Grsliy/Tapping-system-for-laboratory/Referensi/Modul_IoT_sementara.pdf

Modul Internet of Things: Menggunakan STM32 + ESP01 Praktikum Senior Project, Lab Dasar 2 Departemen Teknik Elektro dan Teknologi Informasi, Fakultas Teknik, Universitas Gadjah Mada

Pengaturan IOC pada STM32CubeIDE

### 1. Buat New Project sesuai dengan tipe STM32 kalian, contoh: STM32F401CDU6, sampai

selesai dan tertampil file IOC kalian.

### 2. Klik “System Core” > RCC > High Speed Clock (HSE) set sebagai “Crystal/Ceramic

Resonator”

### 3. Klik “System Core” > SYS > Debug set sebagai “Serial Wire” 4. Klik “Connectivity” > USART1 > Mode set sebagai “Asynchronous” dan pastikan pada

Parameter Settings > Basic Parameters > Baud Rate > 115200 Bits/s

### 5. Kilk save sampai ter-generate main.c, kemudian edit main.c berikut:

Percobaan 1: STM32+ESP01 berlaku sebagai server yang membuat its own wifi connection, dan HP/laptop terkoneksi ke wifi stm32 dengan memasukkan SSID dan Password, kemudian membuka website 192.168.51.1 dan mengendalikan LED STM32 menggunakan tombol di website tersebut.

Di user code begin 2:

Departemen Teknik Elektro dan Teknologi Informasi, Fakultas Teknik, Universitas Gadjah Mada

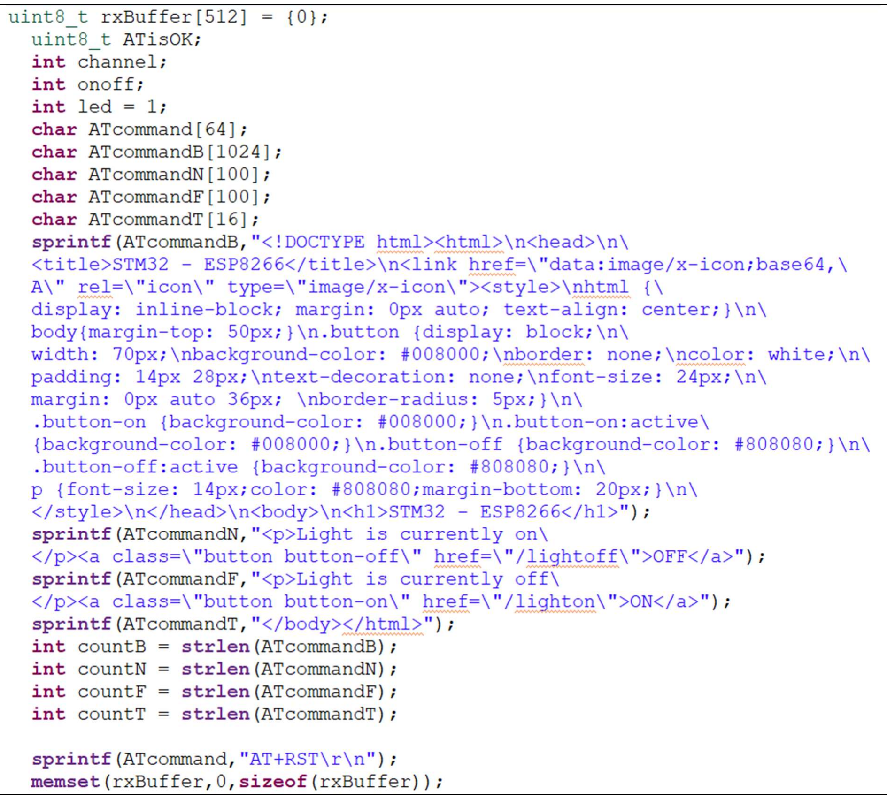
[picture p3: figure]

Departemen Teknik Elektro dan Teknologi Informasi, Fakultas Teknik, Universitas Gadjah Mada

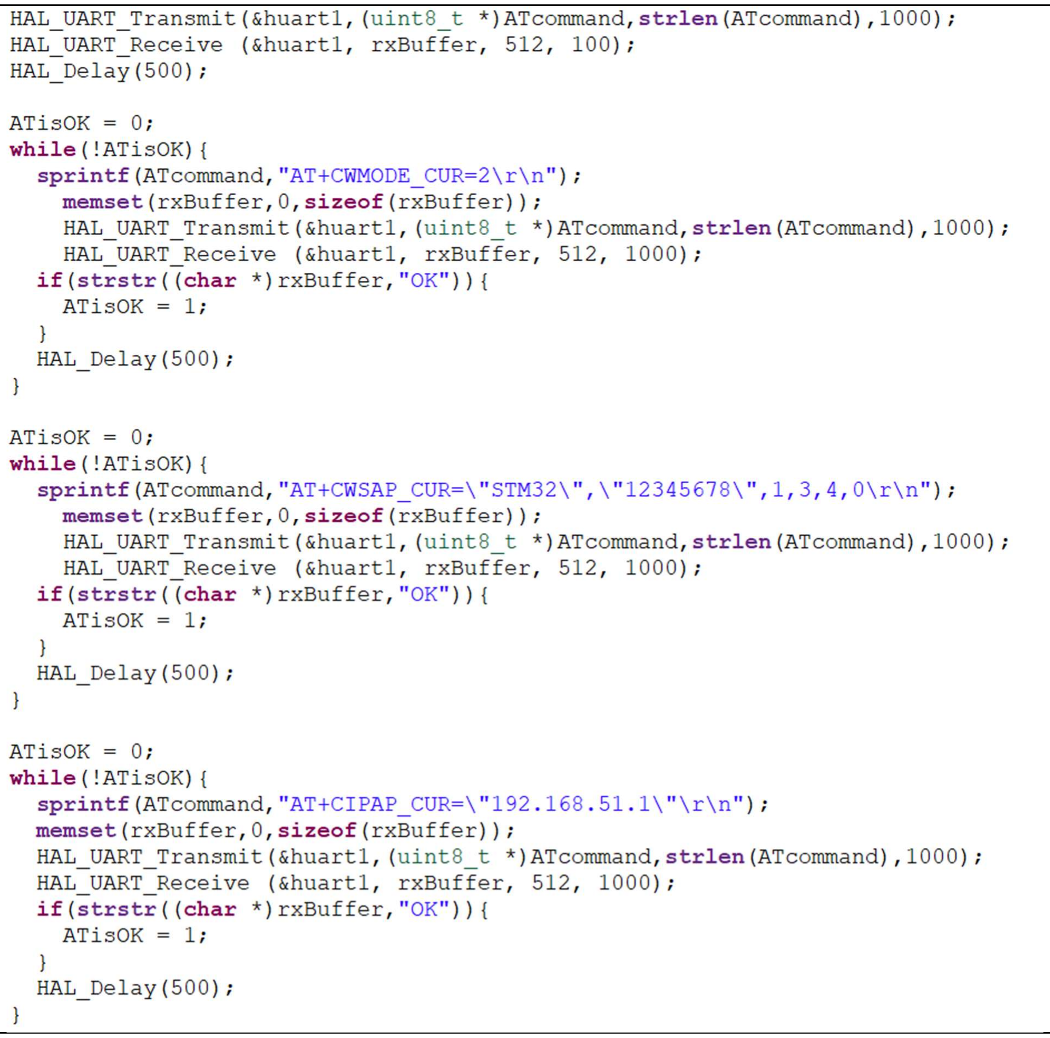
[picture p4: figure]

Departemen Teknik Elektro dan Teknologi Informasi, Fakultas Teknik, Universitas Gadjah Mada

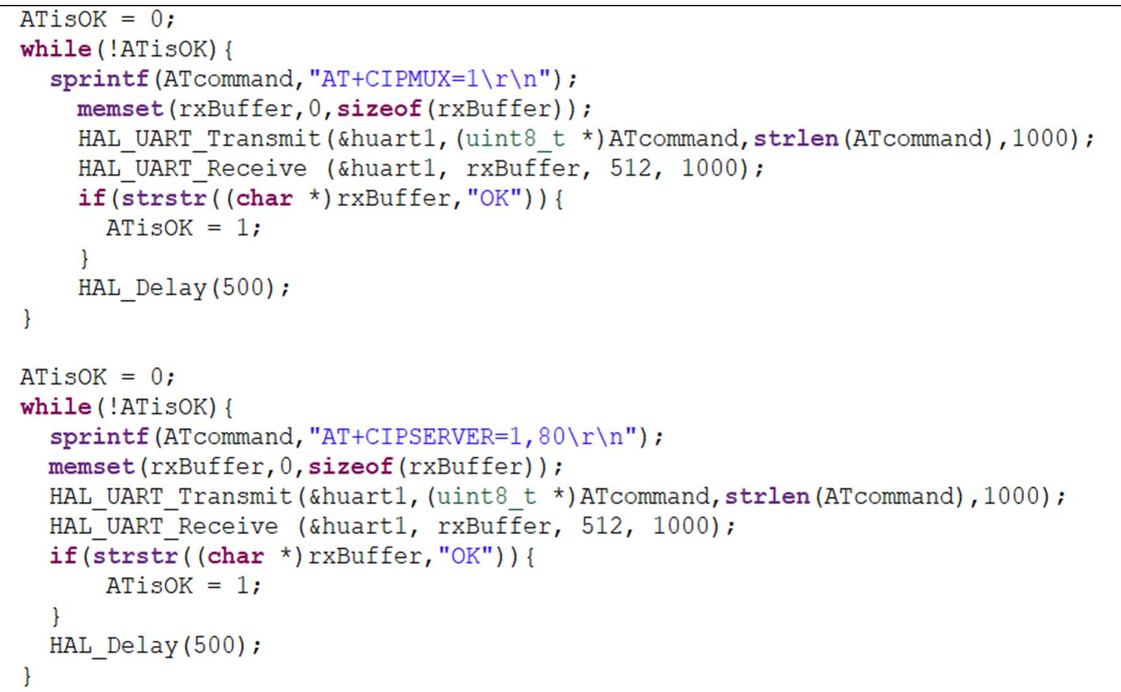
[picture p5: figure]

Kemudian di dalam while(1)

Departemen Teknik Elektro dan Teknologi Informasi, Fakultas Teknik, Universitas Gadjah Mada

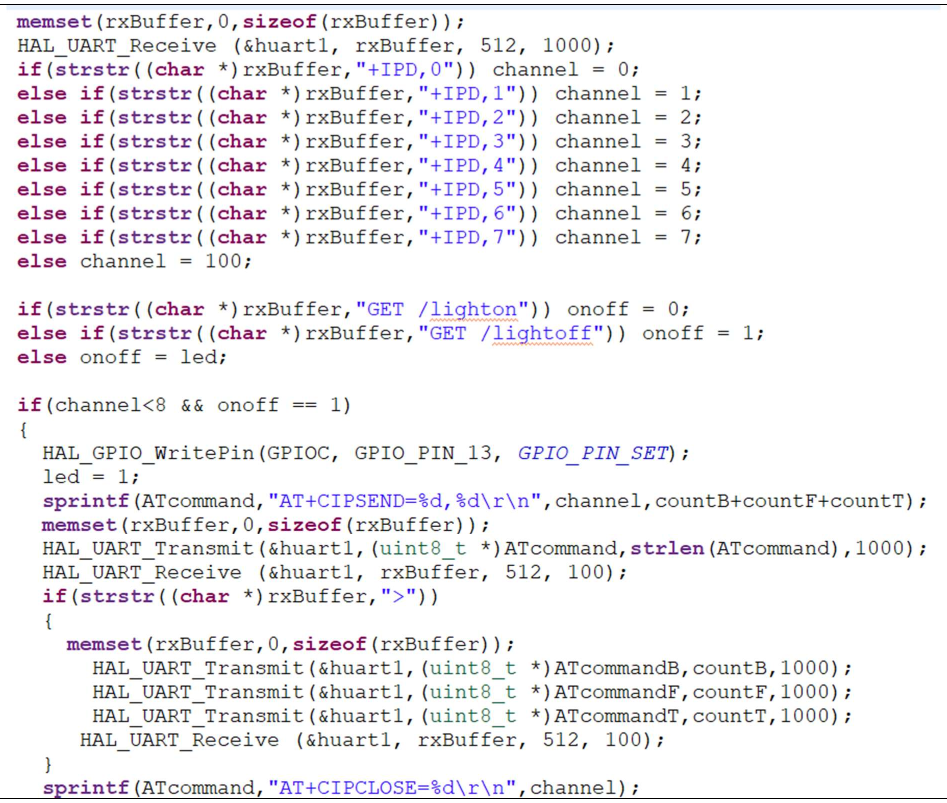
[picture p6: figure]
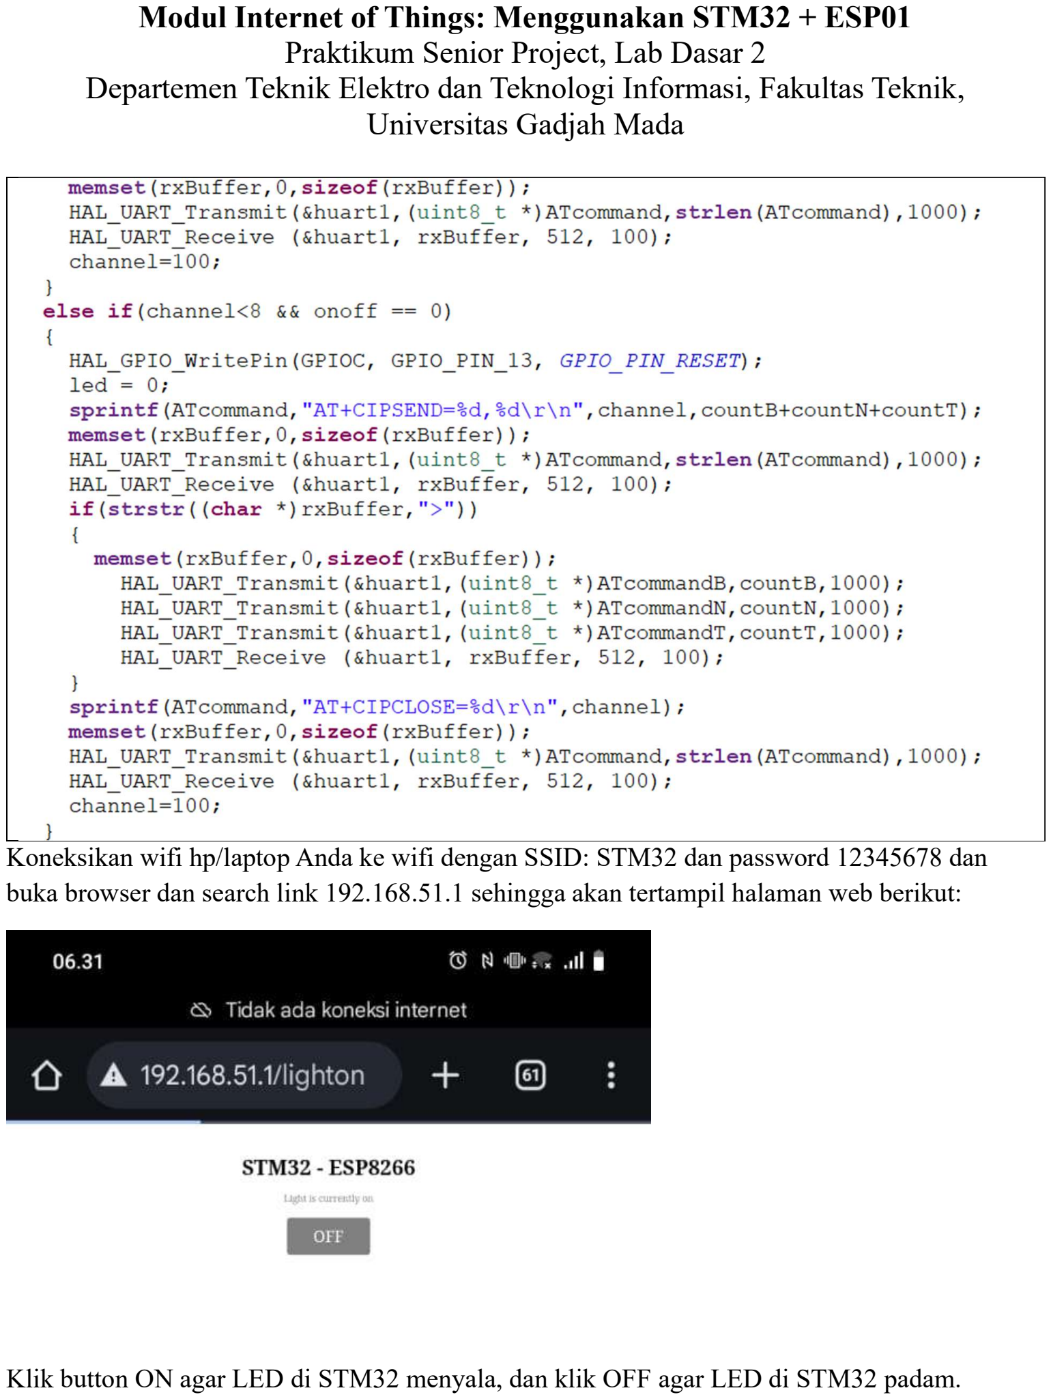
[picture p7: page 6]

Departemen Teknik Elektro dan Teknologi Informasi, Fakultas Teknik, Universitas Gadjah Mada

Koneksikan wifi hp/laptop Anda ke wifi dengan SSID: STM32 dan password 12345678 dan buka browser dan search link 192.168.51.1 sehingga akan tertampil halaman web berikut:

Klik button ON agar LED di STM32 menyala, dan klik OFF agar LED di STM32 padam.

Departemen Teknik Elektro dan Teknologi Informasi, Fakultas Teknik, Universitas Gadjah Mada

Percobaan 2: STM32+ESP01 berlaku sebagai client terkoneksi ke Tethering Internet HP, kemudian publish data ke broker test.mosquitto.org, sedangkan Komputer/laptop berlaku sebagai client 2 dan subscribe data dari broker, dengan topic yang sama dengan yang si-publish oleh STM32+ESP01.

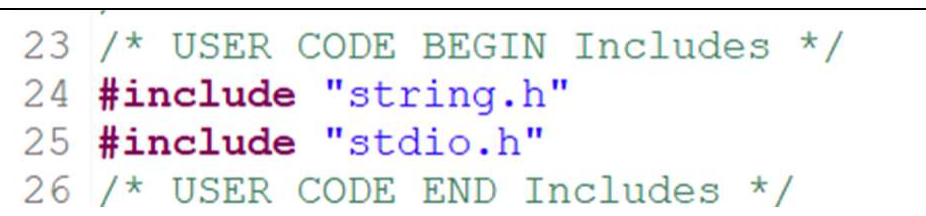
[picture p8: figure]
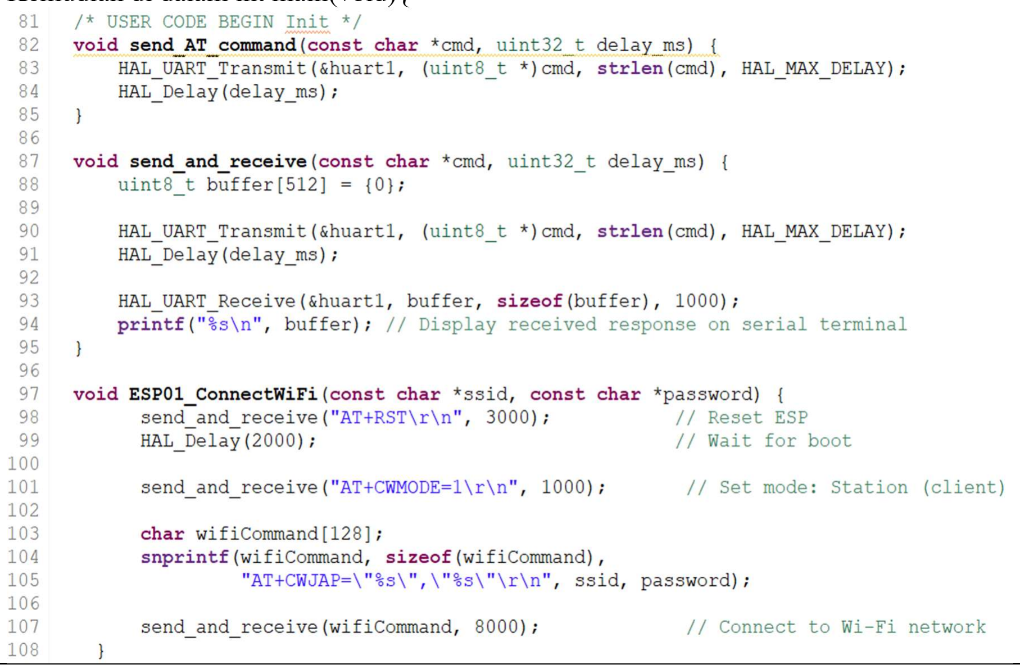
[picture p9: figure]

Kemudian di dalam int main(void){

Departemen Teknik Elektro dan Teknologi Informasi, Fakultas Teknik, Universitas Gadjah Mada

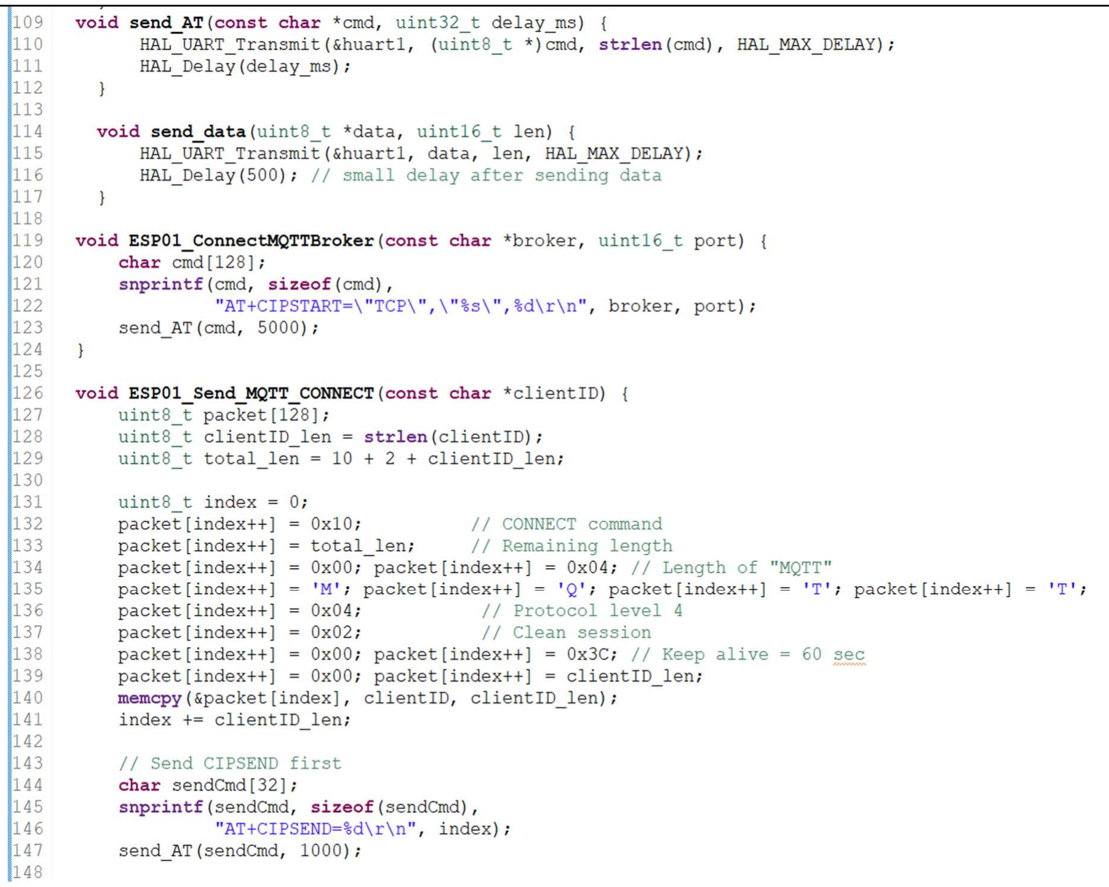
[picture p10: figure]
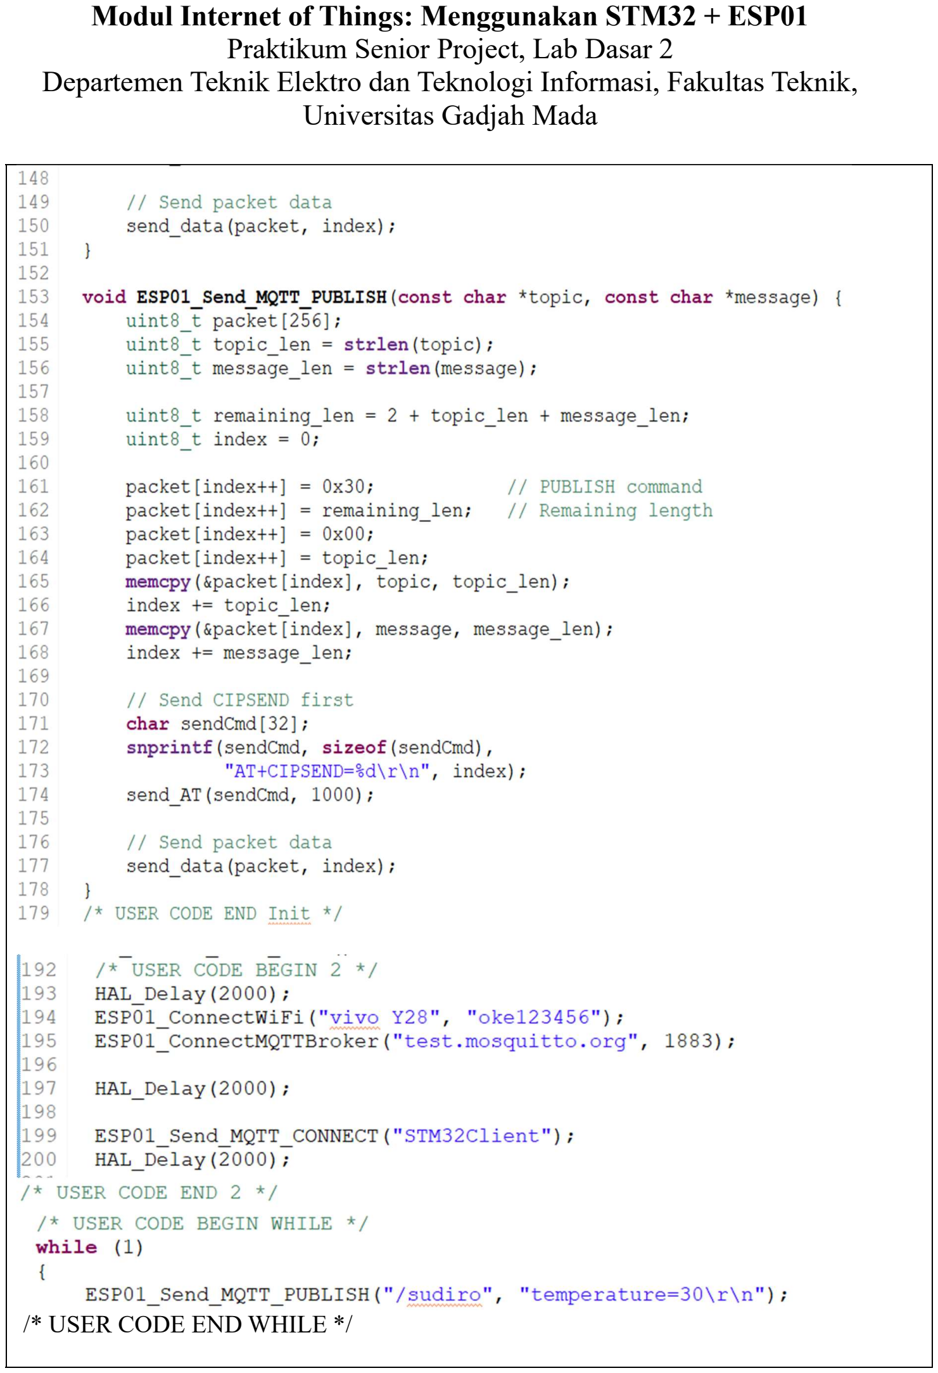
[picture p11: page 9]

Departemen Teknik Elektro dan Teknologi Informasi, Fakultas Teknik, Universitas Gadjah Mada

/* USER CODE END WHILE */

Departemen Teknik Elektro dan Teknologi Informasi, Fakultas Teknik, Universitas Gadjah Mada

Buka Command Prompt: Windows + R ketik cmd ketik mosquito_sub -h test.mosquitto.org -t “/topic”

Percobaan 3:
