Grsliy/Tapping-system-for-laboratory/Referensi/Modul_IoT_v3may2025.pdf

Modul Internet of Things: Menggunakan STM32 + ESP01 Praktikum Senior Project, Lab Dasar 2 Departemen Teknik Elektro dan Teknologi Informasi, Fakultas Teknik, Universitas Gadjah Mada

Pengaturan IOC pada STM32CubeIDE

### 1. Buat New Project sesuai dengan tipe STM32 kalian, contoh: STM32F401CDU6, sampai

selesai dan tertampil file IOC kalian.

### 2. Klik “System Core” > RCC > High Speed Clock (HSE) set sebagai “Crystal/Ceramic

Resonator”

### 3. Klik “System Core” > SYS > Debug set sebagai “Serial Wire” 4. Klik “Connectivity” > USART1 > Mode set sebagai “Asynchronous” dan pastikan pada

Parameter Settings > Basic Parameters > Baud Rate > 115200 Bits/s

### 5. Kilk save sampai ter-generate main.c, kemudian edit main.c berikut:

Percobaan 1: STM32+ESP01 berlaku sebagai server yang membuat its own wifi connection, dan HP/laptop terkoneksi ke wifi stm32 dengan memasukkan SSID dan Password, kemudian membuka website 192.168.51.1 dan mengendalikan LED STM32 menggunakan tombol di website tersebut.

Di user code begin 2:

Departemen Teknik Elektro dan Teknologi Informasi, Fakultas Teknik, Universitas Gadjah Mada


Departemen Teknik Elektro dan Teknologi Informasi, Fakultas Teknik, Universitas Gadjah Mada


Departemen Teknik Elektro dan Teknologi Informasi, Fakultas Teknik, Universitas Gadjah Mada


Kemudian di dalam while(1)

Departemen Teknik Elektro dan Teknologi Informasi, Fakultas Teknik, Universitas Gadjah Mada


Departemen Teknik Elektro dan Teknologi Informasi, Fakultas Teknik, Universitas Gadjah Mada

Koneksikan wifi hp/laptop Anda ke wifi dengan SSID: STM32 dan password 12345678 dan buka browser dan search link 192.168.51.1 sehingga akan tertampil halaman web berikut:

Klik button ON agar LED di STM32 menyala, dan klik OFF agar LED di STM32 padam.

Departemen Teknik Elektro dan Teknologi Informasi, Fakultas Teknik, Universitas Gadjah Mada

Percobaan 2: STM32+ESP01 berlaku sebagai client terkoneksi ke Tethering Internet HP, kemudian publish data ke broker test.mosquitto.org, sedangkan Komputer/laptop berlaku sebagai client 2 dan subscribe data dari broker, dengan topic yang sama dengan yang si-publish oleh STM32+ESP01.

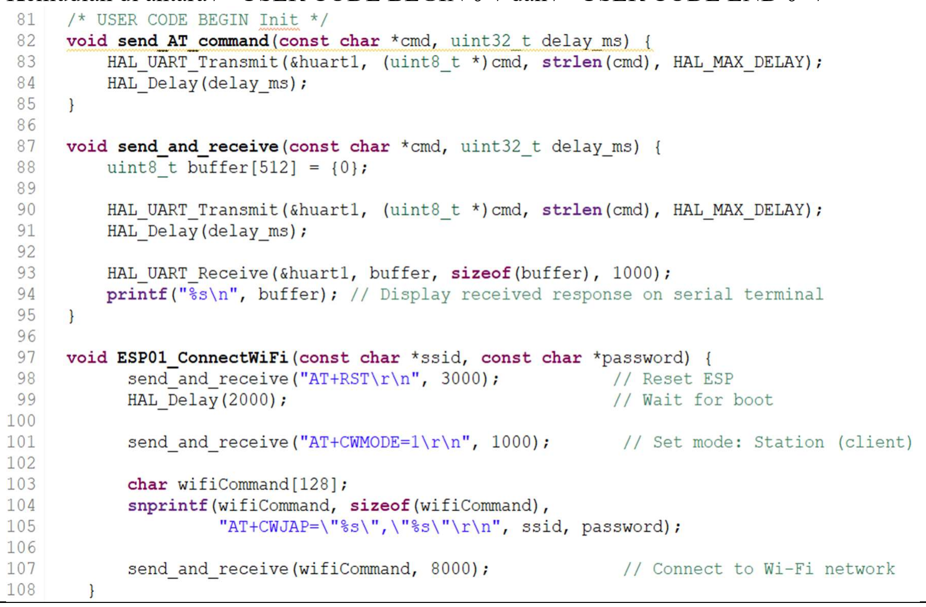
[picture p12: figure]

Kemudian di antara /* USER CODE BEGIN 0*/ dan /* USER CODE END 0 */

Departemen Teknik Elektro dan Teknologi Informasi, Fakultas Teknik, Universitas Gadjah Mada

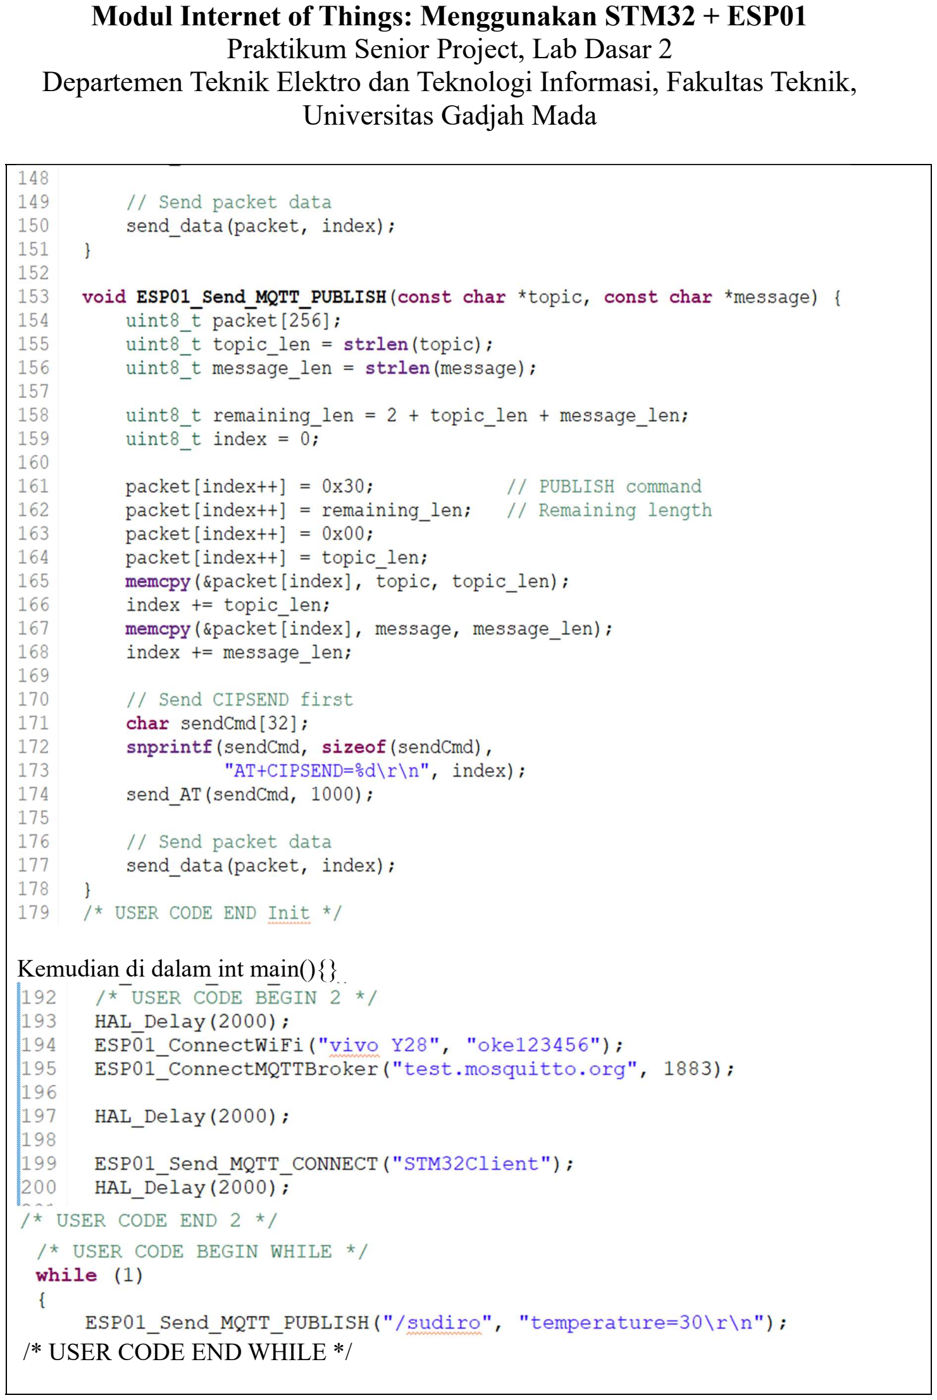
[picture p13: page 9]

Departemen Teknik Elektro dan Teknologi Informasi, Fakultas Teknik, Universitas Gadjah Mada

Kemudian di dalam int main(){}

/* USER CODE END WHILE */

Departemen Teknik Elektro dan Teknologi Informasi, Fakultas Teknik, Universitas Gadjah Mada

Buka Command Prompt: Windows + R ketik cmd, cd ke Lokasi Anda menginstall mosquito, kemudian ketikkan:
mosquito_sub -h test.mosquitto.org -t “/topic”

Percobaan 3: STM32+ESP01 berlaku sebagai client men-subscribe topic yang dikirimkan oleh computer/laptop client ke server dengan topik yang sama, dan menampilkan ke Serial Oscilloscope.

Tidak perlu membuat file project baru, cukup, tambahkan code di bawah dari main.c Anda di Percobaan 2. Yang menjadikan STM32 Anda melakukan publish sekaligus subscribe topic ke dan dari broker.

Buka file .ioc kemudian Klik “Connectivity” > USART1 > Mode set sebagai “Asynchronous” dan pastikan pada Parameter Settings > Basic Parameters > Baud Rate > 115200 Bits/s

Hubungkan Rx dan Tx dari downloader Anda ke STM32 Anda, kemudian tambahkan code berikut:

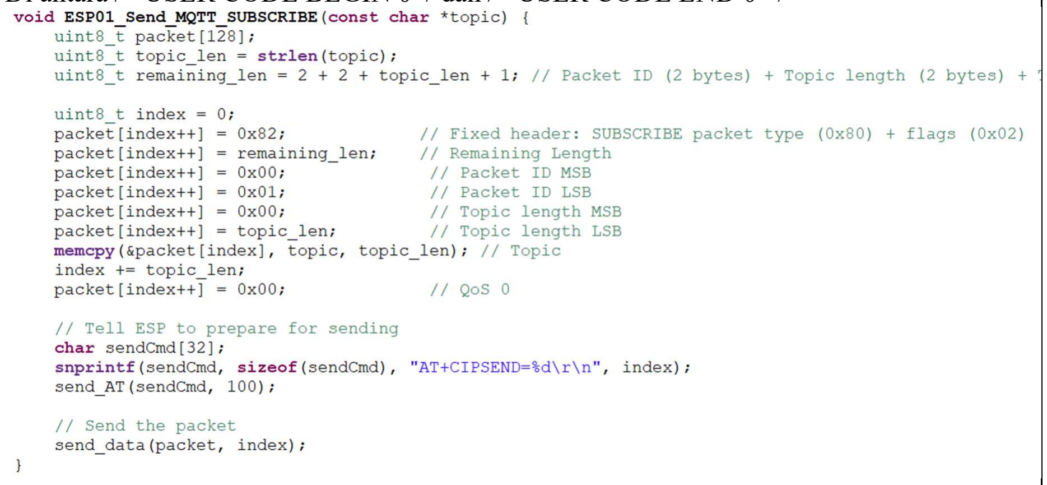
[picture p14: figure]

Di antara /* USER CODE BEGIN 0*/ dan /* USER CODE END 0 */

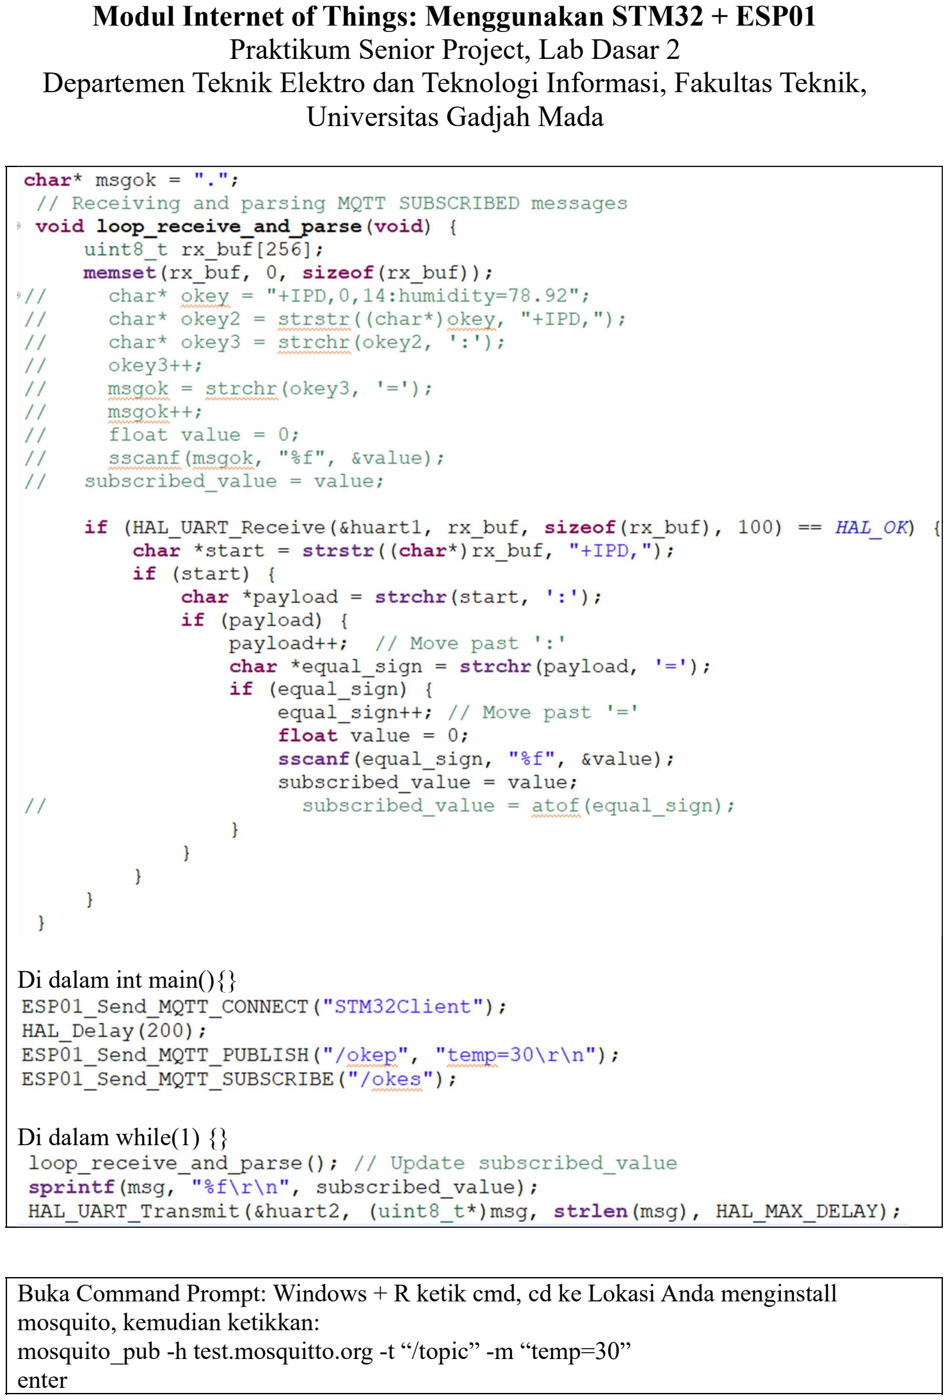
[picture p15: page 11]

Departemen Teknik Elektro dan Teknologi Informasi, Fakultas Teknik, Universitas Gadjah Mada

Di dalam int main(){}

Di dalam while(1) {}

Buka Command Prompt: Windows + R ketik cmd, cd ke Lokasi Anda menginstall mosquito, kemudian ketikkan:
mosquito_pub -h test.mosquitto.org -t “/topic” -m “temp=30”
enter

Departemen Teknik Elektro dan Teknologi Informasi, Fakultas Teknik, Universitas Gadjah Mada

Kemudian buka Serial Oscilloscope, dan buka serial monitor dan oscilloscope nya bersamaan. Jika berhasil, maka yang tertampil adalah angka 30.

Jika berhasil, publish data tersebut dengan mengganti nilai temp, menjadi berikut:

mosquito_pub -h test.mosquitto.org -t “/topic” -m “temp=35”
enter
mosquito_pub -h test.mosquitto.org -t “/topic” -m “temp=40”
enter
mosquito_pub -h test.mosquitto.org -t “/topic” -m “temp=45”
enter

Jika output di serial monitor berubah menunjukkan 35, 40, dan 45, maka Anda sukses.

Percobaan 4. Publish data secara kontinyu menggunakan python code, menjadikan computer Anda sebagai client1 sedangkan STM32 Anda men subscribe dan menampilkan data tersebut di serial oscilloscope.

Project yang dipakai sama dengan Percobaan 3, Anda hanya butuh membuat file Python Bernama yourname.py berikut:

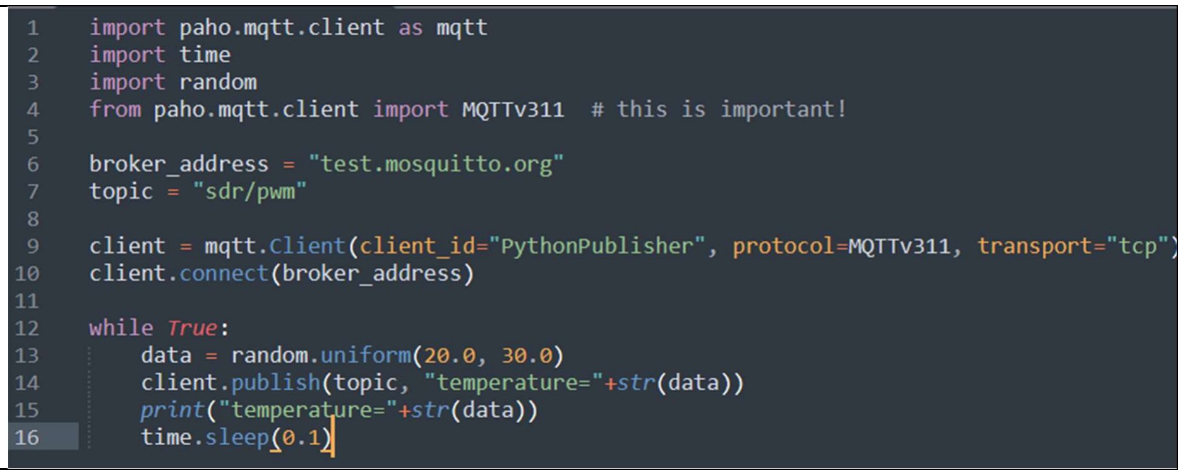
[picture p16: figure]

Eksekusi file python Anda dengan mengetik kan

python yournem.py

di CMD Anda kemudian klik Enter.

Jangan lupa sesuaikan nama topik yang ingin Anda subscribe di STM32 harus sama dengan nama topic yang Anda publish di file python ini.

Departemen Teknik Elektro dan Teknologi Informasi, Fakultas Teknik, Universitas Gadjah Mada

Percobaan 5. [Komunikasi dua buah STM32] Pada percobaan ini, pasang Potensiometer dengan kaki Tengah ke pin ADC PA6 di STM32 Anda, sedangkan kedua kakinya, satu dihubungkan ke pin 3V3 dan G di STM32 Anda. Gunakan ADC Polling.

Hubungkan kutub positif dan negative kipas ke power supply 5V (merah) dan Nol (hitam). Hubungkan pin PWM kipas ke pin PWM PA7 di STM32 teman Anda.

STM32 Anda: Buat project baru persis dengan di Percobaan 2, dengan mengubah data yang publish adalah data bacaan ADC.

STM32 teman Anda: Buat project baru persis dengan Percobaan 3 (fungsi send_AT, send_data, ESP01_ConnectMQTTBroker, dan ESP01_Send_MQTTConnect disamakan dengan Percobaan 2), dengan menambahkan perintah membangkitkan PWM di fungsi loop_receive_and_parse()

Hubungkan STM32 Anda dan teman Anda, ke satu tethering HP yang sama. Sesuaikan nama topik yang Anda publish dengan topik yang disubscribe teman Anda. Kemudian Run.

Anda dan teman Anda sukses jika dengan memutar potensiometer Anda, kipas di teman Anda ikut berubah kecepatannya.
