Grsliy/Tapping-system-for-laboratory/Casing/kucing-kotak-menyatu/ilustrasi-isi-kotak.png

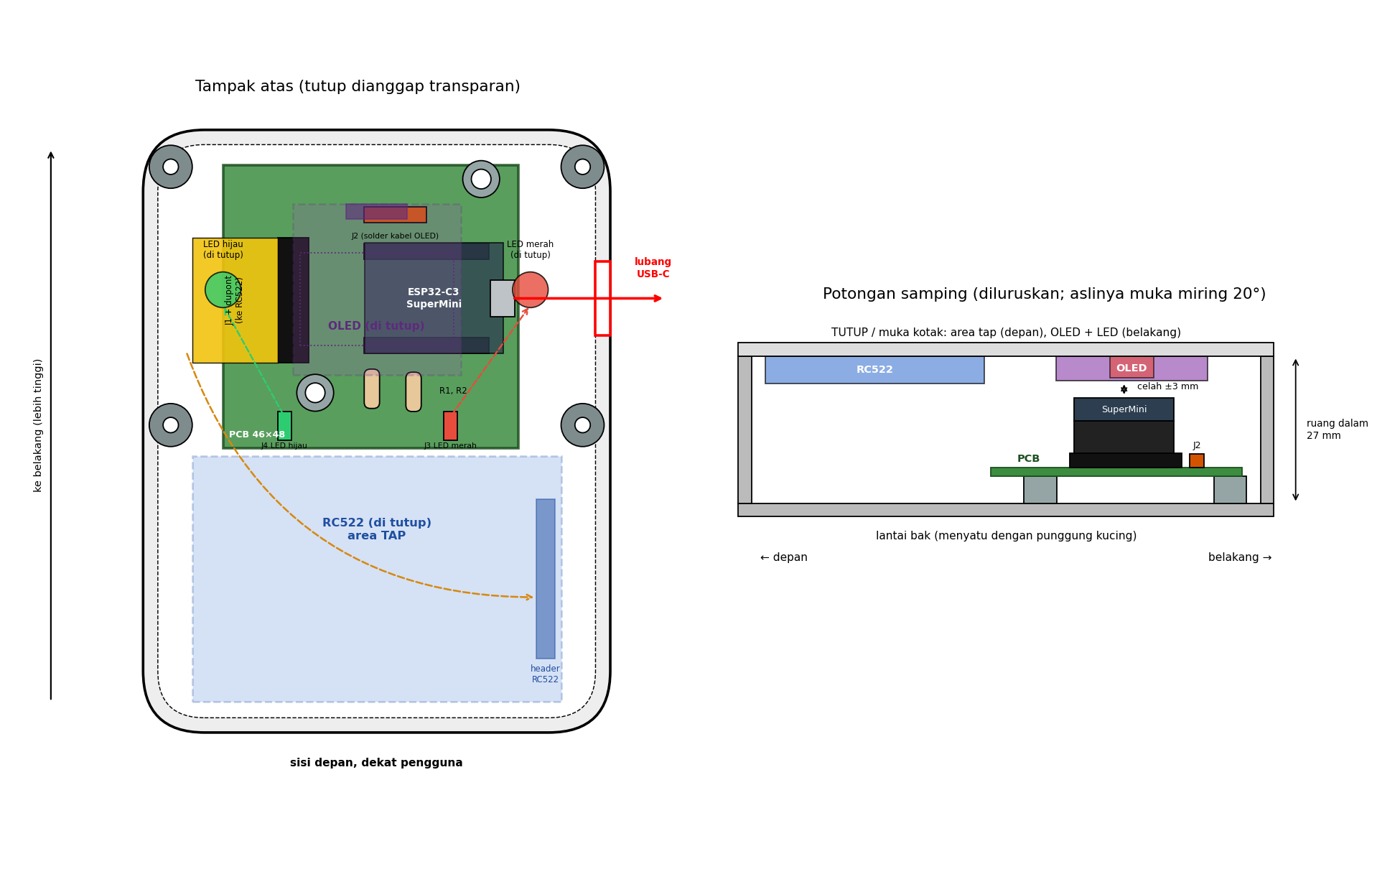
Casing/kucing-kotak-menyatu/ilustrasi-isi-kotak.png
