Grsliy/Tapping-system-for-laboratory/Casing/kucing-kotak-menyatu/pratinjau-kucing-kotak-menyatu.png

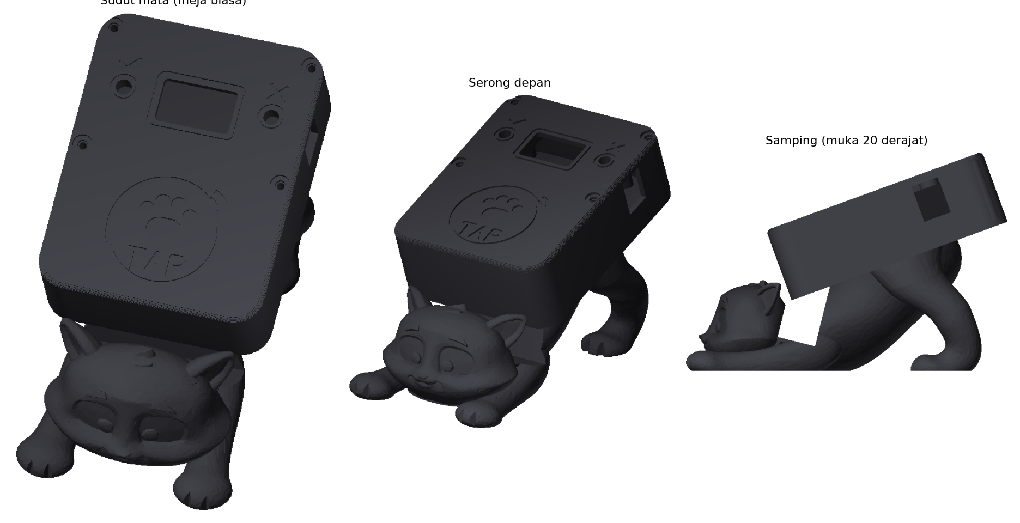
Casing/kucing-kotak-menyatu/pratinjau-kucing-kotak-menyatu.png
