Grsliy/Tapping-system-for-laboratory/Gambar/skematik.png

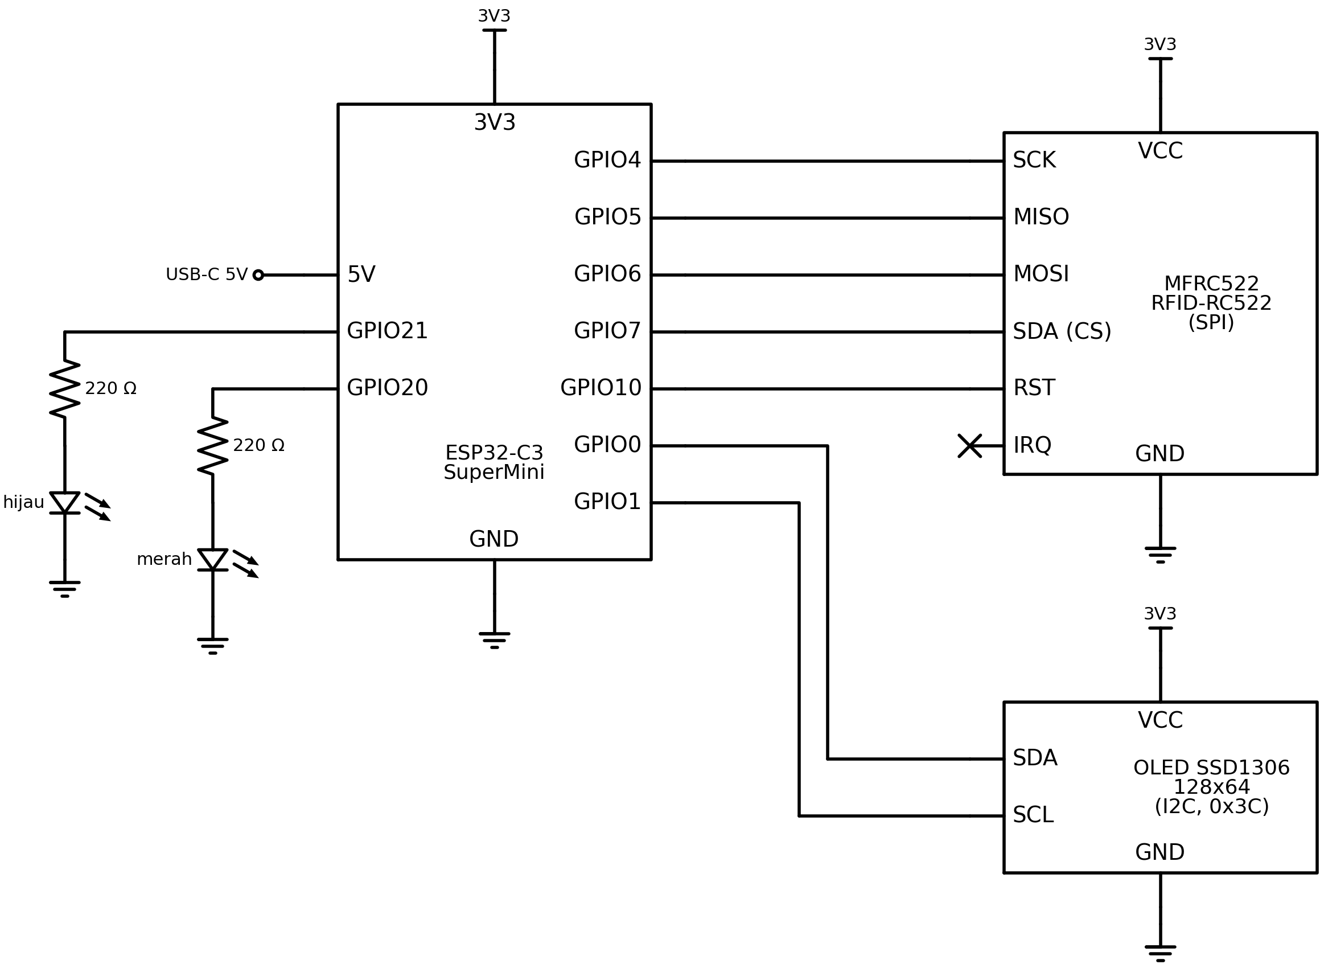
Gambar/skematik.png
