Grsliy/Tapping-system-for-laboratory/PCB/pratinjau-atas.png

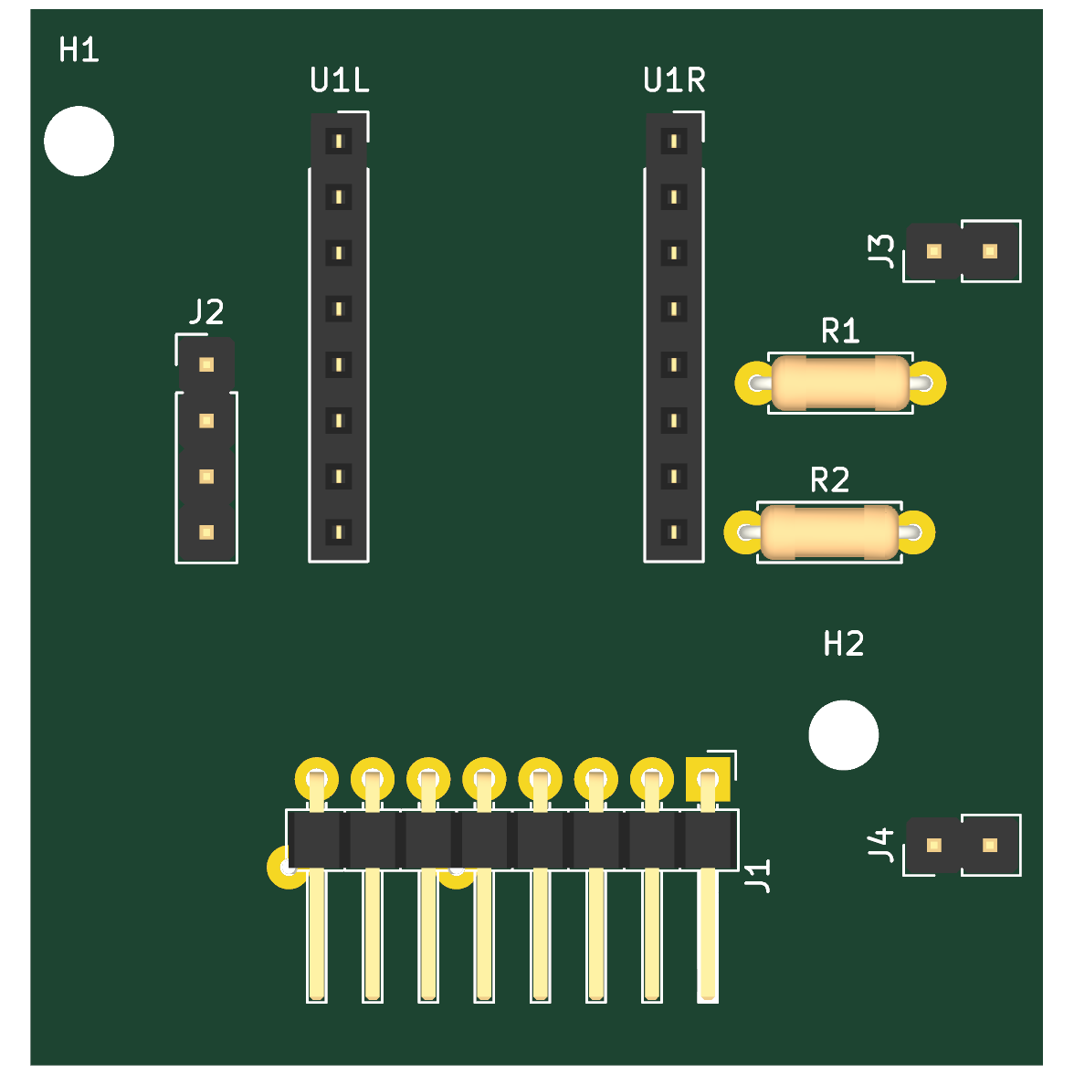
PCB/pratinjau-atas.png
