Grsliy/Tapping-system-for-laboratory/PCB/pratinjau-bawah.png

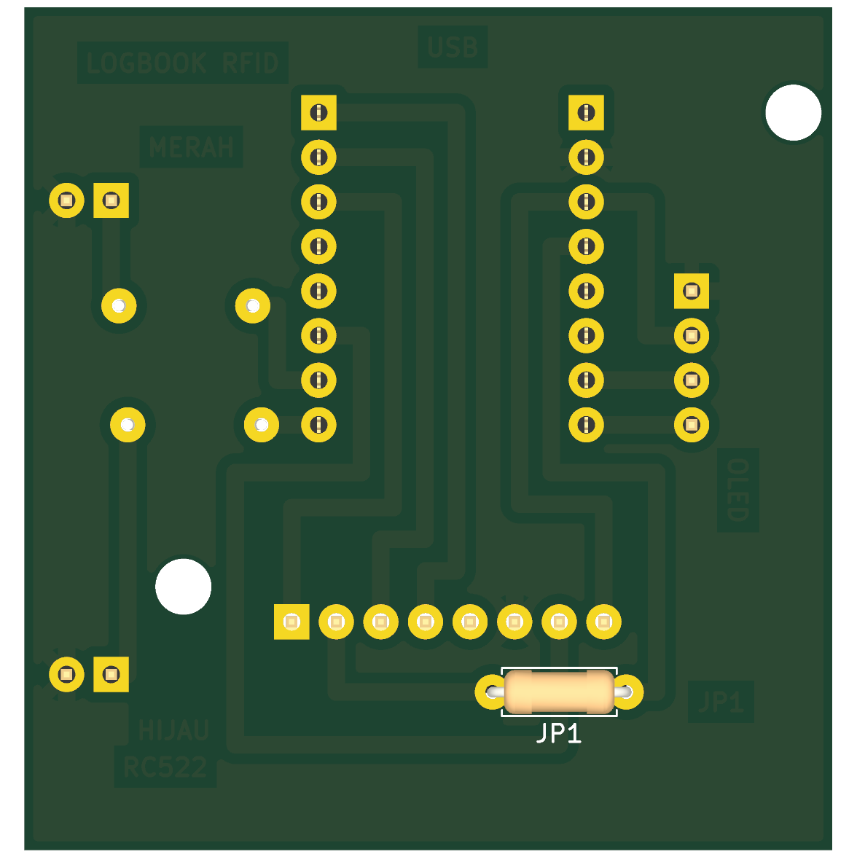
PCB/pratinjau-bawah.png
