Grsliy/Tapping-system-for-laboratory/Referensi/esp01-pinout-reference.png

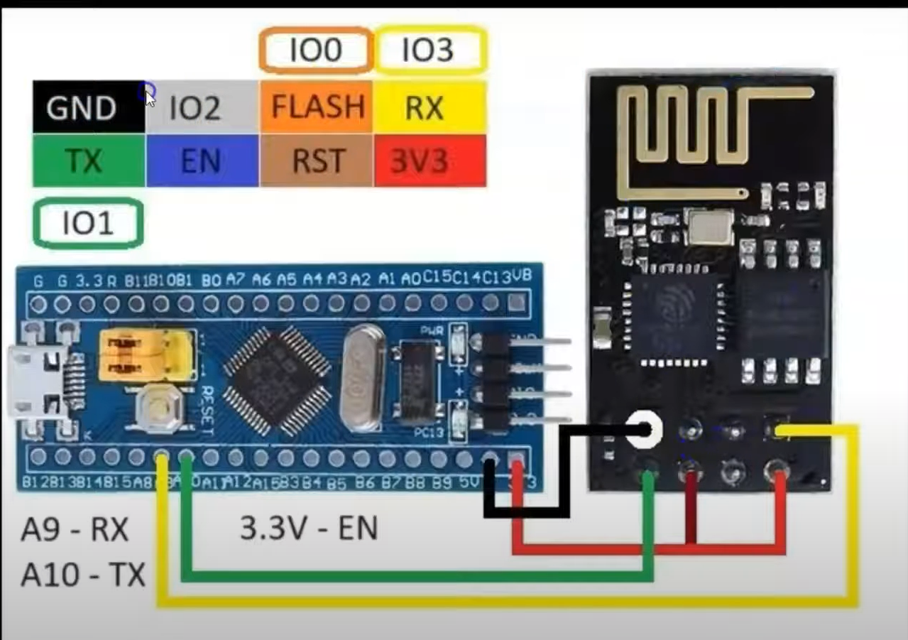
Referensi/esp01-pinout-reference.png
