Grsliy/Tapping-system-for-laboratory/Casing/kucing-kotak-menyatu/cetak-bersama.stl

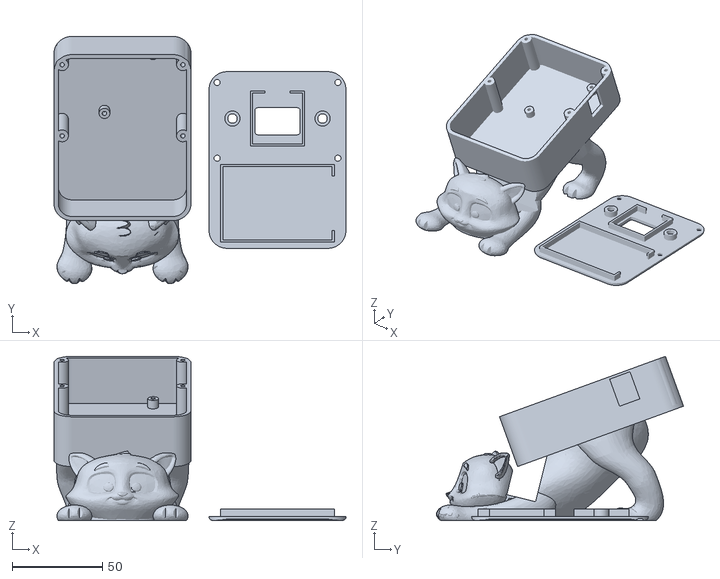
[picture p23: CAD file, 2026-11-01]
Casing/kucing-kotak-menyatu/cetak-bersama.stl
162.0 x 137.1 x 91.1
