Grsliy/Tapping-system-for-laboratory/Casing/kucing-kotak-menyatu/tutup.stl

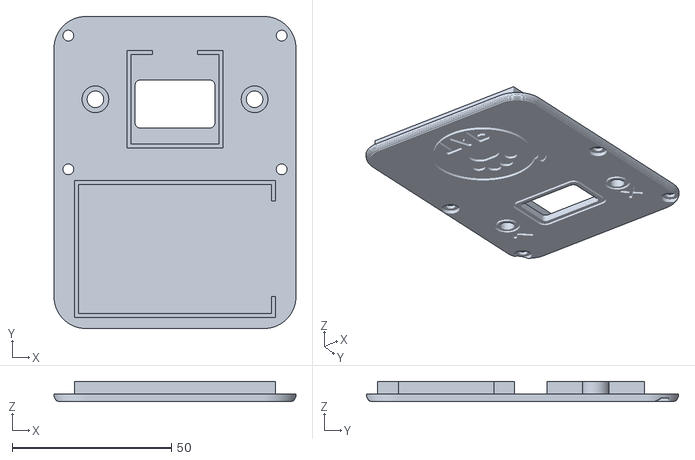
[picture p24: CAD file, 2026-11-01]
Casing/kucing-kotak-menyatu/tutup.stl
76.0 x 98.0 x 6.40
