Grsliy/Tapping-system-for-laboratory/Casing/kucing-kotak-menyatu/kucing-kotak.stl

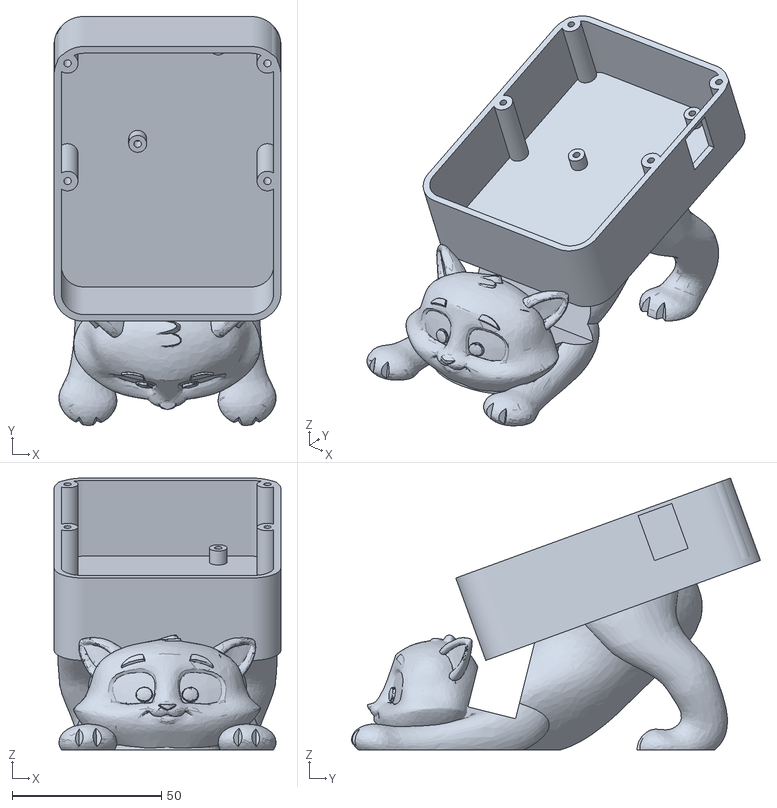
[picture p25: CAD file, 2026-11-01]
Casing/kucing-kotak-menyatu/kucing-kotak.stl
76.0 x 137.1 x 91.1
