Grsliy/Tapping-system-for-laboratory/PCB/cetak-toner-B_Cu.pdf

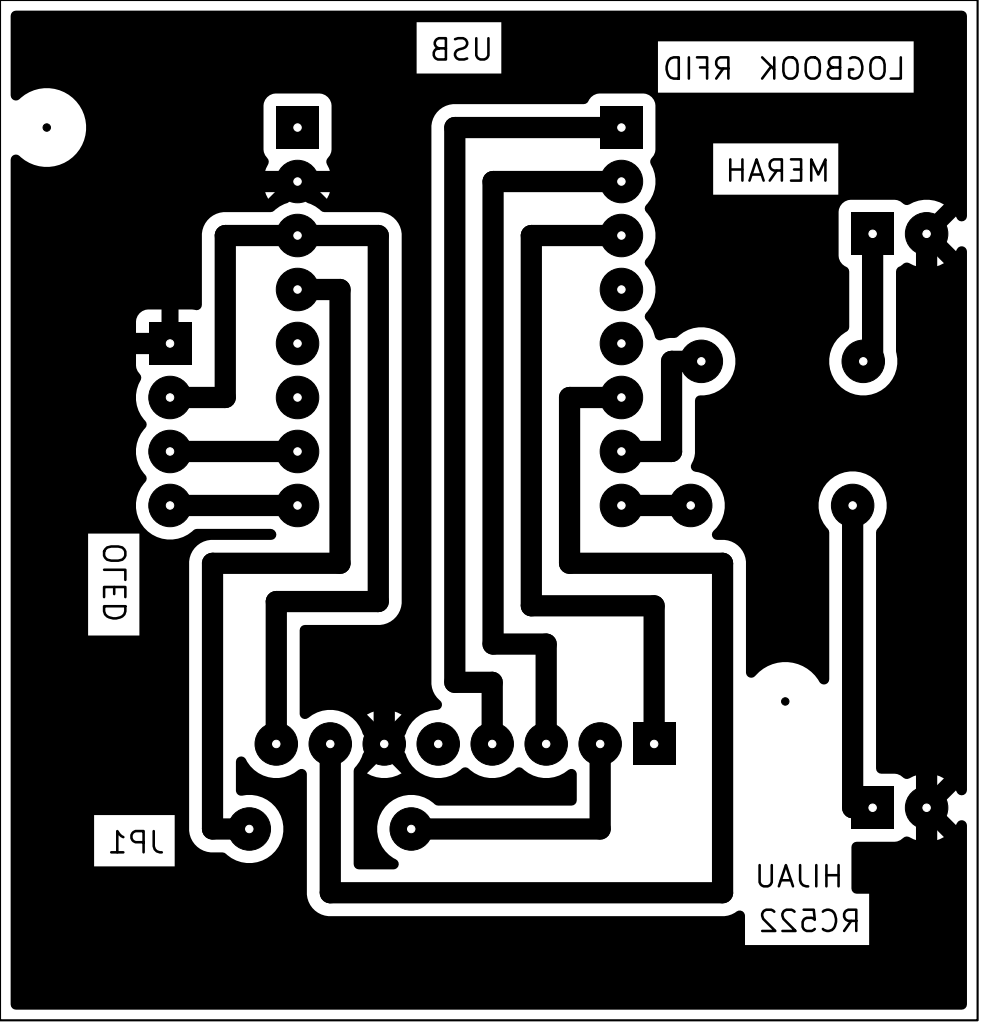
[picture p29: page 1]
