Grsliy/Tapping-system-for-laboratory/PCB/logbook-rfid.kicad_pcb

## KiCad design PCB/logbook-rfid.kicad_pcb (2026-11-02)

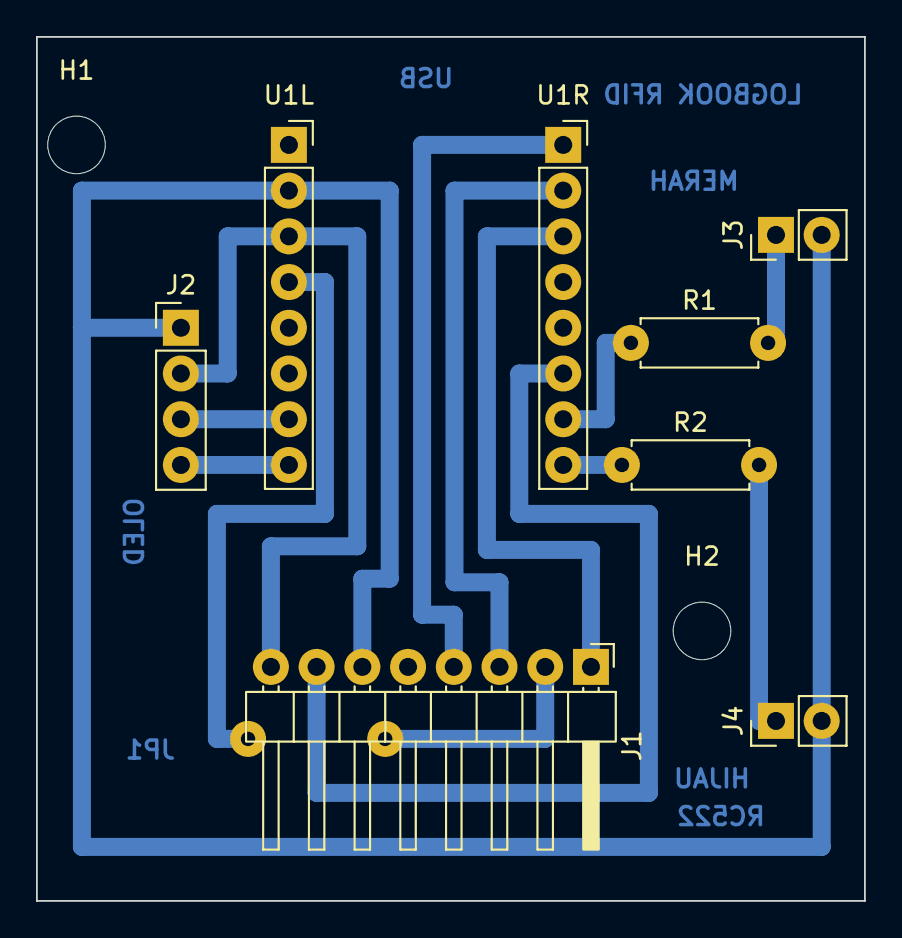
[picture p30: board logbook-rfid.kicad_pcb from above]

Board: 2 copper layers, 46.0 x 48.0 mm, 11 parts (1 on the bottom side), 13 nets.

Parts:
H1, H2: M3; MountingHole_3.2mm_M3
J1: RC522; PinHeader_1x08_P2.54mm_Horizontal
J2: OLED (solder); PinHeader_1x04_P2.54mm_Vertical
J3: LED merah (solder); PinHeader_1x02_P2.54mm_Vertical
J4: LED hijau (solder); PinHeader_1x02_P2.54mm_Vertical
JP1: kabel berisolasi; R_Axial_DIN0207_L6.3mm_D2.5mm_P7.62mm_Horizontal
R1, R2: 220; R_Axial_DIN0207_L6.3mm_D2.5mm_P7.62mm_Horizontal
U1L: SuperMini kiri; PinSocket_1x08_P2.54mm_Vertical
U1R: SuperMini kanan; PinSocket_1x08_P2.54mm_Vertical

Connections:
3V3: J1.8, J2.2, U1L.3
CS: J1.1, U1R.3
GND: J1.6, J2.1, J3.2, J4.2, U1L.2
LED_G: R2.1, U1R.8
LED_G_A: J4.1, R2.2
LED_R: R1.1, U1R.7
LED_R_A: J3.1, R1.2
MISO: J1.4, U1R.1
MOSI: J1.3, U1R.2
RST: J1.7, U1R.6
SCK: J1.2, JP1.1, U1L.4
SCL: J2.3, U1L.7
SDA: J2.4, U1L.8
