Grsliy/Tapping-system-for-laboratory/logbook-firmware/src/popcat.h

#pragma once

#include <Arduino.h>

// Popcat 2 frame (mulut tertutup, terbuka) untuk layar kartu belum terdaftar, 1-bit.
// Dikonversi dari GIF popcat transparan: bagian gelap (garis tepi, mata, mulut) jadi
// putih di OLED. Format baris demi baris, MSB kiri (format drawBitmap Adafruit GFX).
#define POPCAT_WIDTH  60
#define POPCAT_HEIGHT 60
#define POPCAT_FRAMES 2

static const unsigned char PROGMEM popcat0[] = {
    0x00, 0x00, 0x00, 0x00, 0x00, 0x03, 0xC0, 0x00,
    0x00, 0x00, 0x00, 0x00, 0x00, 0x0E, 0x40, 0x00,
    0x00, 0x00, 0x00, 0x00, 0x00, 0x1B, 0x60, 0x00,
    0x7E, 0x00, 0x00, 0x00, 0x00, 0x34, 0x60, 0x00,
    0x43, 0x80, 0x00, 0x00, 0x00, 0x68, 0x20, 0x00,
    0x40, 0xE0, 0x00, 0x00, 0x01, 0xC0, 0x20, 0x00,
    0xDC, 0x30, 0x00, 0x01, 0x83, 0x00, 0x20, 0x00,
    0xD3, 0x1C, 0x00, 0x03, 0xFE, 0x00, 0x20, 0x00,
    0xD0, 0xC7, 0x00, 0x1E, 0x01, 0x80, 0x30, 0x00,
    0xD0, 0x23, 0xC0, 0xF8, 0x00, 0x60, 0x30, 0x00,
    0x50, 0x10, 0x7F, 0xC0, 0x00, 0x00, 0x30, 0x00,
    0x40, 0x08, 0x00, 0x00, 0x00, 0x02, 0x30, 0x00,
    0x40, 0x02, 0x00, 0x00, 0x00, 0x01, 0x30, 0x00,
    0x40, 0x01, 0x00, 0x00, 0x00, 0x00, 0x70, 0x00,
    0x60, 0x00, 0x80, 0x00, 0x00, 0x04, 0x10, 0x00,
    0x60, 0x00, 0x00, 0x00, 0x00, 0x1F, 0x10, 0x00,
    0x20, 0x00, 0x00, 0x18, 0x00, 0x1F, 0x18, 0x00,
    0x30, 0x00, 0x00, 0x7E, 0x00, 0x1F, 0x08, 0x00,
    0x30, 0x00, 0x00, 0xF7, 0x00, 0x1F, 0x0C, 0x00,
    0x18, 0x00, 0x01, 0xFF, 0x80, 0x1F, 0x06, 0x00,
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
    0x00, 0x20, 0x00, 0xFF, 0xFF, 0xFF, 0xFC, 0x60,
    0x00, 0x30, 0x00, 0xFF, 0xFF, 0xFF, 0xF8, 0x60,
    0x00, 0x10, 0x00, 0x6F, 0xFF, 0xFF, 0xF8, 0x40,
    0x00, 0x18, 0x00, 0x63, 0xFF, 0xFE, 0x30, 0xC0,
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
};

static const unsigned char *const popcat[] = {popcat0, popcat1};
