Grsliy/Tapping-system-for-laboratory/logbook-firmware/src/knight.h

#pragma once

#include <Arduino.h>

// Kucing ksatria berpedang untuk sapaan SPECIAL_UID, 1-bit. Badan dan pedang dikonversi dari
// pixel art berwarna, kepala digambar ulang per piksel. Format baris demi baris, MSB kiri
// (format drawBitmap Adafruit GFX).
#define KNIGHT_WIDTH  30
#define KNIGHT_HEIGHT 64
#define KNIGHT_TIP_X  5 // ujung pedang, tempat kilau berkedip
#define KNIGHT_TIP_Y  0

static const unsigned char PROGMEM knightCat[] = {
    0x04, 0x00, 0x00, 0x00, 0x04, 0x00, 0x00, 0x00,
    0x0E, 0x00, 0x00, 0x00, 0x0E, 0x00, 0x00, 0x00,
    0x0E, 0x00, 0x00, 0x00, 0x0E, 0x00, 0x00, 0x00,
    0x0E, 0x00, 0x00, 0x00, 0x0E, 0x00, 0x00, 0x00,
    0x0E, 0x00, 0x00, 0x00, 0x0E, 0x00, 0x00, 0x00,
    0x0E, 0x40, 0x04, 0x00, 0x0E, 0x60, 0x0C, 0x00,
    0x0E, 0xF0, 0x3C, 0x00, 0x0E, 0xBF, 0xF4, 0x00,
    0x0E, 0xB9, 0xC6, 0x00, 0x0E, 0xD0, 0x06, 0x00,
    0x0E, 0xD0, 0x0E, 0x00, 0x0E, 0xF9, 0xCE, 0x00,
    0x0E, 0xFF, 0xFE, 0x00, 0x0E, 0xC7, 0x8F, 0x00,
    0x0E, 0xA3, 0x47, 0x00, 0x0E, 0x83, 0x07, 0x00,
    0x0E, 0x83, 0x06, 0x00, 0x0E, 0xC7, 0x8F, 0x00,
    0x0E, 0xFC, 0xFE, 0x00, 0x0E, 0xFB, 0x7E, 0x00,
    0x0E, 0xFC, 0xFC, 0x00, 0x0E, 0xFF, 0xF8, 0x00,
    0x0E, 0xFF, 0xE0, 0x00, 0x0E, 0x00, 0x00, 0x00,
    0x7F, 0xFF, 0xFC, 0x00, 0x44, 0x00, 0x7C, 0x00,
    0x3C, 0x39, 0xFE, 0x00, 0x7C, 0x78, 0xF6, 0x00,
    0xFC, 0x79, 0xF6, 0x00, 0xE0, 0x7F, 0xF6, 0x00,
    0xE3, 0xFF, 0xE6, 0x00, 0xC7, 0xFF, 0xF6, 0x00,
    0x82, 0x00, 0x76, 0x00, 0x60, 0x00, 0x7F, 0x00,
    0x1C, 0x00, 0x1F, 0x00, 0x14, 0x00, 0x1F, 0x00,
    0x10, 0x00, 0x0F, 0x80, 0x1C, 0x1B, 0x8F, 0x80,
    0x28, 0x03, 0x8F, 0xC0, 0x3D, 0xC1, 0xE7, 0xC0,
    0x39, 0xE1, 0xE7, 0xE0, 0x79, 0xF0, 0x77, 0xE0,
    0x71, 0xF1, 0x03, 0xF0, 0x71, 0xF1, 0xD3, 0xF8,
    0x40, 0x40, 0xE7, 0xF8, 0x6E, 0x00, 0xC7, 0xF8,
    0x7F, 0x19, 0xE7, 0xF8, 0x7F, 0x39, 0xF7, 0xFC,
    0xEF, 0x39, 0xEF, 0xFC, 0x7F, 0x3D, 0xEF, 0xFC,
    0x7F, 0x7C, 0xF7, 0xF8, 0x0F, 0x9A, 0xF4, 0xF0,
    0x1F, 0x81, 0xE8, 0x40, 0x10, 0x81, 0x08, 0x00,
    0x3C, 0x81, 0x7C, 0x00, 0x7D, 0x01, 0x7C, 0x00,
    0xFD, 0x01, 0x7A, 0x00, 0x7F, 0x00, 0xFC, 0x00,
};
