Grsliy/Tapping-system-for-laboratory/(commit log)

2026-09-07 Initial commit: dokumen roadmap, kode STM32, dan backend Flask Fase 1
2026-09-07 Ganti arsitektur: STM32+ESP-01 jadi satu chip Wemos D1 Mini (ESP8266)
    Alasan: WiFi lab pakai eduroam/captive portal yang tidak didukung ESP-01 AT firmware.
2026-09-08 Ganti mikon dari Wemos D1 (ESP8266) ke ESP32-C3, rapikan folder firmware
    Eduroam gagal konsisten di ESP8266 (dugaan batasan TLS 1.0 SDK lama). ESP32-C3
    pakai esp_wpa2.h, terverifikasi dukung PEAP-MSCHAPv2 dari header SDK resmi.
    Folder wemos-firmware/ di-rename jadi logbook-firmware/. Sekalian tambah
    broadcaster UDP (app.py) dan form pendaftaran online (/daftar), keduanya
    sudah teruji.
2026-09-12 Hapus logbook-server/ dan main.txt, pindah arsitektur ke Google Sheets + Apps Script
    logbook-server (Flask+SQLite) sudah tidak dipakai -- PC lab tidak bisa satu jaringan
    dengan ESP32 tanpa hardware tambahan, dan eduroam terbukti tidak stabil di ESP32
    Arduino core (lihat riwayat commit sebelumnya). Google Sheets jadi database, Google
    Apps Script gantikan peran server, menghilangkan kebutuhan PC selalu nyala dan
    satu jaringan dengan device.
    main.txt (salinan lama kode STM32) juga dihapus, sudah tidak relevan.
2026-09-12 Pivot arsitektur ke Google Sheets + Apps Script, susun milestone 5 hari
    Eduroam ditinggalkan setelah gagal konsisten di 3 mikon berbeda (ESP8266, ESP32-C3,
    ESP32 WROOM) dengan berbagai pendekatan -- ketidakstabilan WPA2-Enterprise di
    Arduino-ESP32 core, bukan bug kode sendiri. Server self-hosted (Flask+SQLite) diganti
    Google Sheets + Apps Script, menghilangkan kebutuhan PC selalu nyala satu jaringan
    dengan device dan mekanisme UDP discovery IP dinamis.
2026-09-14 code: add detailed print and timeout
2026-09-14 code: fix API redirect
    [main.cpp]
2026-09-14 code: fix bug esp32 for appscript
    [main.cpp]
2026-09-14 code: fix bug redirect API
    [main.cpp]
2026-09-14 Dokumentasikan Hari 3: 4 kendala teknis ESP32-C3 SuperMini + Apps Script dan fix-nya
2026-09-14 code: fix bug GET REQUEST
    [main.cpp]
2026-09-14 code: rapikan main.cpp, status sepenuhnya lewat OLED
    - Semua output Serial dihapus, termasuk Serial.begin().
    - MFRC522 diperiksa di setup(); layar menampilkan "RFID check wiring" kalau
    modul tidak membalas SPI sama sekali.
    - loop() mengecek WiFi.status(), bukan flag wifiReady yang tidak pernah
    dikembalikan ke false, sehingga WiFi yang putus di tengah jalan sebelumnya
    tidak pernah disambung ulang.
    - Buffer balasan MFRC522 dinaikkan ke 16 byte. ToCard bisa menyalin sebanyak
    itu sementara pemanggilnya hanya menyediakan 2 dan 5 byte.
    - postJson dan getContent digabung jadi httpRequest; balasan 302 tidak lagi
    membaca body yang langsung dibuang.
2026-09-14 doc: perbaiki anchor link di Hari 1
    Menunjuk #milestone-5-hari yang sudah tidak ada sejak bagian tersebut
    digabung menjadi "Status dan Rencana Kerja" di dokumen utama.
2026-09-14 doc: tambah Tutorial Hari 5 tentang umpan balik OLED
    Mencatat wiring OLED beserta alasan memilih GPIO0/GPIO1 di atas pin I2C
    default, cara mengkonversi frame bongo cat dari format page QMK ke format
    baris yang dibaca Adafruit_GFX, dan tiga kendala yang ditemukan:
    - Flag wifiReady yang diturunkan saat tap gagal, yang membuat satu
    kegagalan merobohkan koneksi WiFi yang masih sehat.
    - Loop percobaan ulang redirect yang selalu meminta alamat lama, sehingga
    rantai redirect tidak pernah diikuti sampai habis.
    - Cara memisahkan masalah jaringan dari masalah perangkat setelah keluaran
    Serial dihapus, memakai dua uji independen lewat UDP dan TCP.
2026-09-14 doc: sebutkan layar OLED di README
    Cara kerja bertambah langkah kelima untuk umpan balik ke pengunjung, dan
    bagian Arsitektur menyebut perangkat kini berdiri sendiri di pintu masuk
    tanpa komputer yang tersambung.
2026-09-14 doc: perbarui dokumen rancangan ke kondisi setelah OLED
    - OLED masuk daftar komponen di bagian Arsitektur.
    - Bagian Pinout baru: tabel sambungan MFRC522 dan OLED beserta alasan
    menghindari GPIO8/GPIO9 yang merupakan pin strapping di SuperMini.
    - Tabel status bertambah Hari 5 (selesai) dan Hari 6 (belum mulai).
    - Bagian Riwayat Rilis baru, mencatat v1.0 dan v1.1 apa adanya termasuk
    bahwa perubahan sesudahnya belum masuk rilis bertanda.
    - "Yang masih tersisa" diganti "Yang Masih Terbuka": kebutuhan jaringan
    dirinci sampai ke script.googleusercontent.com yang mudah terlewat,
    kartu tidak terdaftar dicoret karena sudah diuji di Hari 4, dan
    ditambah usulan mengantrekan tap yang gagal ter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
2026-09-14 doc: pasang foto prototipe di README
    Foto alat menyala ditaruh di bawah paragraf pembuka, lebarnya dibatasi
    420 piksel karena fotonya potret dan akan memakan hampir satu layar penuh
    kalau direntangkan selebar konten. Link diagram arsitektur ikut menyesuaikan
    lokasi barunya di folder Gambar.
2026-09-14 doc: pasang foto keadaan layar di Tutorial Hari 5
    Tiga foto disusun sebagai tabel tiga kolom di bagian Hasil akhir, supaya
    susunannya sendiri menunjukkan bahwa ketiganya satu urutan: menunggu
    balasan, kartu terdaftar, lalu kartu belum terdaftar.
2026-11-01 code: tambah LED status hijau dan merah untuk hasil tap
    Hijau menyala saat tap tercatat (GPIO21), merah menyala saat kartu belum terdaftar (GPIO20), merah berkedip saat pengiriman gagal. Keduanya padam bersama layar kembali ke Please tap.
2026-11-01 code: abaikan riwayat lokal dan backup otomatis KiCad
2026-11-01 pcb: tambah script pembangun PCB single-layer
    Routing manual di B.Cu dengan KiCad 10 Python API: PCB 46x48 mm, ground fill, satu kabel jumper (JP1), header siku J1/J2 dan J3 tanpa header supaya muat di casing kucing-kotak-menyatu.
2026-11-01 pcb: tambah berkas proyek KiCad hasil script
2026-11-01 pcb: tambah Gerber bottom copper, outline, dan drill
2026-11-01 pcb: tambah pratinjau render PCB sisi atas dan bawah
2026-11-01 casing: tambah script casing kucing dengan kotak menyatu
    Remix dari Cute Cat Phone Holder karya ABoyNamedSue (thingiverse.com/thing:7095121, CC BY-SA). Kucing diperbesar 1.5x, bak kotak elektronik menyatu di punggungnya dengan muka miring 20 derajat.
2026-11-01 casing: tambah STL kucing-kotak dan tutup
2026-11-01 casing: tambah STL cetak bersama untuk satu plate
2026-11-01 pcb: tambah Gerber.zip siap unggah ke pabrik PCB
2026-11-02 pcb: ikuti urutan pin modul OLED (GND, VDD, SCK, SDA) di J2
    Modul OLED yang dipakai berurutan GND, VDD, SCK, SDA, sedangkan J2 sebelumnya mengikuti modul prototipe (VCC, GND). Dicolok lurus, catu daya OLED terbalik.
2026-11-02 pcb: sesuaikan lubang M3 dan J2 dengan casing yang sudah dicetak
    PCB diputar sehingga USB menghadap dinding kanan bak. Lubang M3 dipindah ke (2.2, 6) dan (36.95, 33) di atas standoff tercetak, J2 menjadi pad solder karena tidak ada ruang untuk dupont.
2026-11-02 pcb: pisah pad LED merah dan hijau mendekati letak LED di tutup
    J3 (merah) dan J4 (hijau) masing-masing anoda + GND, di sisi kanan dan kiri bak.
2026-11-02 pcb: perbarui berkas KiCad hasil revisi
2026-11-02 pcb: perbarui Gerber dan drill
2026-11-02 pcb: perbarui Gerber.zip
2026-11-02 pcb: tambah PDF bottom copper untuk toner transfer
    Skala 1:1, tidak di-mirror, titik bor di tengah pad.
2026-11-02 pcb: perbarui pratinjau render PCB
2026-11-02 casing: perbaiki rumus penempatan PCB di script casing
    Rumus lama mencerminkan papan. Rumus baru u = 23 - y_pcb, v = 92.2 - x_pcb adalah rotasi dengan komponen menghadap atas, cocok dengan standoff dan lubang USB casing yang sudah dicetak.
2026-11-02 casing: tambah ilustrasi letak PCB di dalam kotak
2026-11-02 ref: hapus gambar wiring ESP-01 yang tidak dipakai
2026-11-02 doc: lengkapi struktur folder di README
    Tambah Gambar/, PCB/, dan Casing/ beserta kredit lisensi model kucing (CC BY-SA).
2026-11-03 pcb: tambah mode milling di script PCB
    Routing sama, ground fill disederhanakan untuk software CNC yang hang pada poligon rumit: tanpa teks tembaga, pad GND tersambung penuh, lingkaran dipecah lebih kasar. Titik poligon fill turun dari 1569 ke 576.
2026-11-03 pcb: tambah Gerber dan drill khusus milling
    Dibuat dengan buat_pcb.py mode milling. Gerber di PCB/Gerber tetap untuk pabrik dan toner transfer.
2026-11-03 code: animasi bongo cat dan nama diketik di layar Welcome
2026-11-03 code: animasi popcat di layar kartu belum terdaftar
